vogelchr/resolver-to-sincos/resolver-to-sincos-rev-a/resolver-to-sincos.pdf

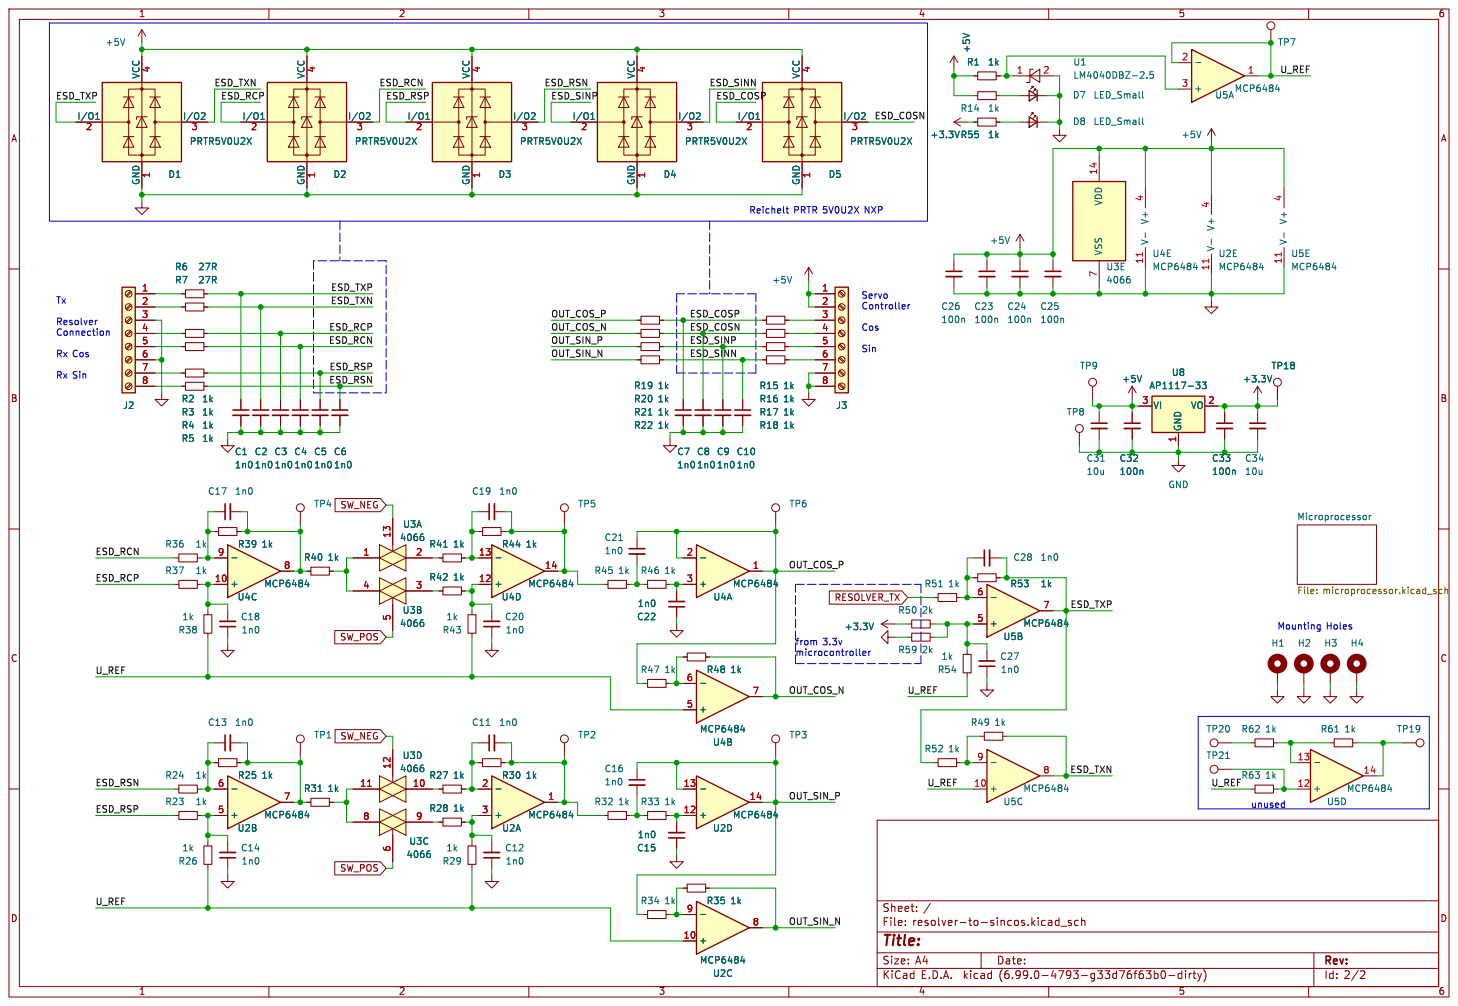
[picture p1: page 1]

from 3.3v microcontroller Servo Controller Cos Sin

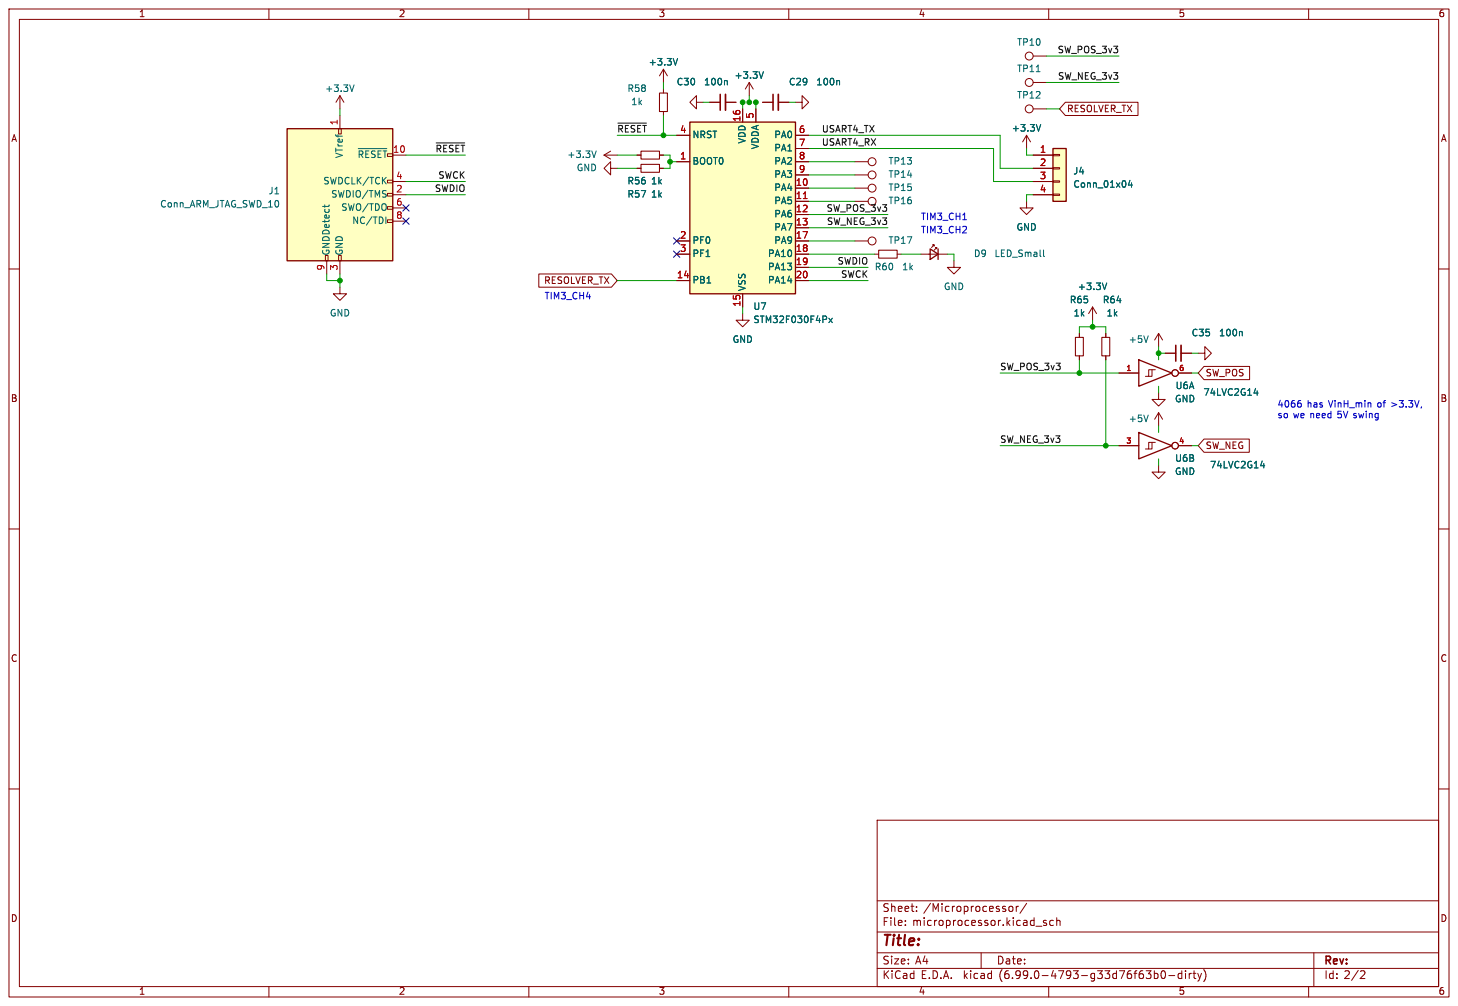
[picture p2: page 2]

3 SWDCLK/TCK 4 SWO/TDO 6 NC/TDI 8 GNDDetect 9

4066 has VinH_min of >3.3V, so we need 5V swing GND
