vogelchr/resolver-to-sincos/resolver-to-sincos.kicad_pcb

## KiCad design resolver-to-sincos.kicad_pcb (2022-12-24)

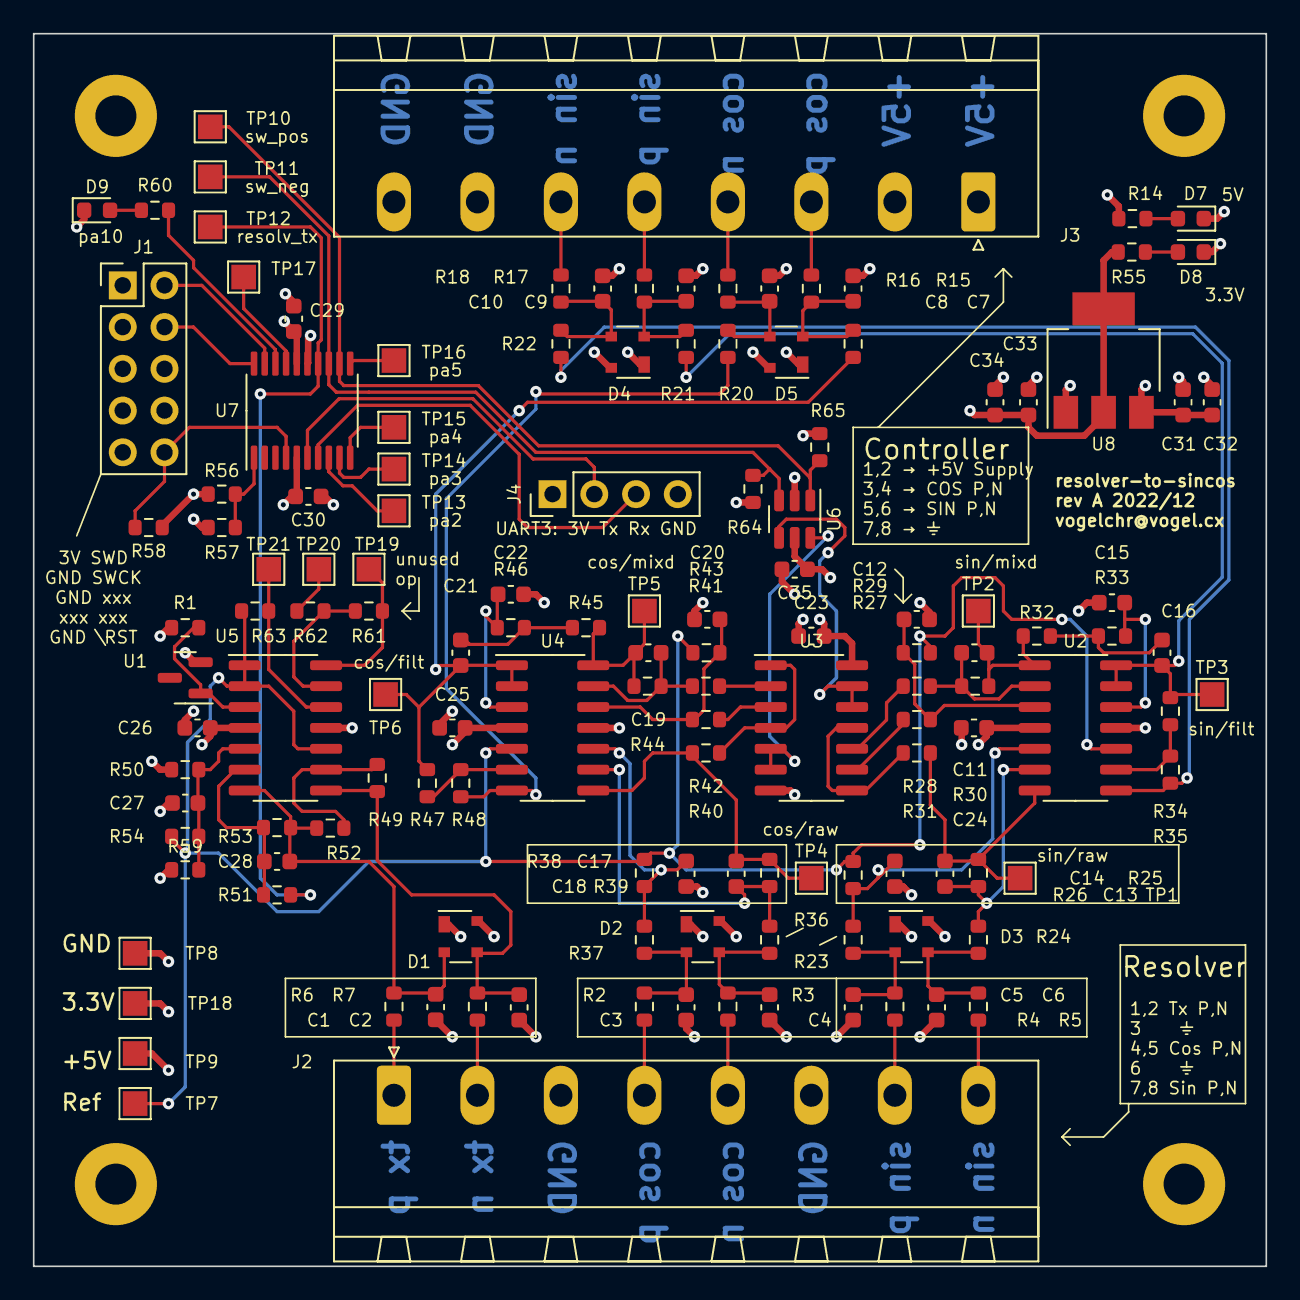
[picture p3: board resolver-to-sincos.kicad_pcb from above]

Board: 4 copper layers, 75.0 x 75.0 mm, 139 parts (0 on the bottom side), 80 nets.

Parts:
C1, C2, C3, C4, C5, C6, C7, C8, C9, C10, C11, C12, C13, C17, C19, C20: 0.1n; C_0603_1608Metric
C14, C18, C27, C28: 1n0; C_0603_1608Metric
C15, C16, C21, C22: 10n; C_0603_1608Metric
C23, C24, C25, C26, C29, C30, C32, C33, C35: 100n; C_0603_1608Metric
C31, C34: 10u; C_0603_1608Metric
D1, D2, D3, D4, D5: PRTR5V0U2X; SOT-143
D7, D8, D9: LED_Small; LED_0603_1608Metric
H1, H2, H3, H4: MountingHole_Pad; MountingHole_2.5mm_Pad
J1: Conn_ARM_JTAG_SWD_10; PinHeader_2x05_P2.54mm_Vertical
J2, J3: Screw_Terminal_01x08; PhoenixContact_MSTBA_2,5_8-G-5,08_1x08_P5.08mm_Horizontal
J4: Conn_01x04; PinHeader_1x04_P2.54mm_Vertical
R1, R14, R55, R60: 1k; R_0603_1608Metric
R2, R3, R4, R5, R23, R24, R27, R28, R31, R36, R37, R40, R41, R42, R49, R51, R52, R53, R54, R61, R62, R63: 27k; R_0603_1608Metric
R6, R7, R15, R16, R17, R18, R19, R20, R21, R22: 68R; R_0603_1608Metric
R25, R26, R29, R30, R38, R39, R43, R44, R50, R56, R57, R58, R59, R64, R65: 51k; R_0603_1608Metric
R32, R33, R34, R35, R45, R46, R47, R48: 33k; R_0603_1608Metric
TP1, TP2, TP3, TP4, TP5, TP6, TP7, TP8, TP9, TP10, TP11, TP12, TP13, TP14, TP15, TP16, TP17, TP18, TP19, TP20, TP21: TestPoint; TestPoint_Pad_1.5x1.5mm
U1: LM4040DBZ-2.5; SOT-23
U2, U4, U5: MCP6484; SOIC-14_3.9x8.7mm_P1.27mm
U3: 4066; SOIC-14_3.9x8.7mm_P1.27mm
U6: 74LVC2G14; SOT-23-6
U7: STM32F030F4Px; TSSOP-20_4.4x6.5mm_P0.65mm
U8: AP1117-33; SOT-223-3_TabPin2

Connections:
+3.3V: C29.1, C30.2, C33.1, C34.1, J1.1 (VTref), J4.1, R50.1, R55.1, R56.1, R58.1, R64.1, R65.1, TP18.1, U7.5 (VDDA), U7.16 (VDD), U8.2 (VO)
+5V: C23.1, C24.1, C25.1, C26.1, C31.1, C32.1, C35.1, D1.4 (VCC), D2.4 (VCC), D3.4 (VCC), D4.4 (VCC), D5.4 (VCC), J3.1, J3.2, R1.1, R14.1, TP9.1, U2.4 (V+), U3.14 (VDD), U4.4 (V+), U5.4 (V+), U6.5 (VCC), U8.3 (VI)
/ESD_COSN: C8.1, D5.3 (I/O2), R16.1, R20.2
/ESD_COSP: C7.1, D5.2 (I/O1), R15.1, R19.2
/ESD_RCN: C4.1, D2.3 (I/O2), R3.2, R36.1
/ESD_RCP: C3.1, D2.2 (I/O1), R2.2, R37.1
/ESD_RSN: C6.1, D3.3 (I/O2), R5.2, R24.1
/ESD_RSP: C5.1, D3.2 (I/O1), R4.2, R23.1
/ESD_SINN: C10.1, D4.3 (I/O2), R18.1, R22.2
/ESD_SINP: C9.1, D4.2 (I/O1), R17.1, R21.2
/ESD_TXN: C2.1, D1.3 (I/O2), R7.2, R49.2, U5.8
/ESD_TXP: C1.1, C28.2, D1.2 (I/O1), R6.2, R52.1, R53.2, U5.7
/Microprocessor/SWCK: J1.4 (SWDCLK/TCK), U7.20 (PA14)
/Microprocessor/SWDIO: J1.2 (SWDIO/TMS), U7.19 (PA13)
/Microprocessor/SW_NEG_3v3: R64.2, TP11.1, U6.3, U7.13 (PA7)
/Microprocessor/SW_POS_3v3: R65.2, TP10.1, U6.1, U7.12 (PA6)
/Microprocessor/USART4_RX: J4.3, U7.7 (PA1)
/Microprocessor/USART4_TX: J4.2, U7.6 (PA0)
/Microprocessor/~RESET: J1.10 (~RESET), R58.2, U7.4 (NRST)
/OUT_COS_N: R20.1, R48.2, U4.7
/OUT_COS_P: C21.1, R19.1, R47.1, TP6.1, U4.1, U4.2 (-)
/OUT_SIN_N: R22.1, R35.2, U2.8
/OUT_SIN_P: C16.1, R21.1, R34.1, TP3.1, U2.13 (-), U2.14
/U_REF: R26.1, R29.1, R38.1, R43.1, R54.1, R63.1, TP7.1, U2.10 (+), U4.5 (+), U5.1, U5.2 (-), U5.10 (+)
GND: C1.2, C2.2, C3.2, C4.2, C5.2, C6.2, C7.2, C8.2, C9.2, C10.2, C12.1, C14.1, C15.1, C18.1, C20.1, C22.1, C23.2, C24.2, C25.2, C26.2, C27.1, C29.2, C30.1, C31.2, C32.2, C33.2, C34.2, C35.2, D1.1 (GND), D2.1 (GND), D3.1 (GND), D4.1 (GND), D5.1 (GND), D7.1 (K), D8.1 (K), D9.1 (K), H1.1, H2.1, H3.1, H4.1, J1.3 (GND), J1.5 (GND), J1.9 (GNDDetect), J2.3, J2.6, J3.7, J3.8, J4.4, R57.1, R59.1, TP8.1, U1.2 (A), U2.11 (V-), U3.7 (VSS), U4.11 (V-), U5.11 (V-), U6.2 (GND), U7.15 (VSS), U8.1 (GND)
unnamed: C11.2, R30.2, R32.1, TP2.1, U2.1
unnamed: C13.2, R25.2, R31.1, TP1.1, U2.7
unnamed: C16.2, R32.2, R33.1
unnamed: C17.2, R39.2, R40.1, TP4.1, U4.8
unnamed: C19.2, R44.2, R45.1, TP5.1, U4.14
unnamed: C21.2, R45.2, R46.1
unnamed: D7.2 (A), R14.2
unnamed: D8.2 (A), R55.2
unnamed: D9.2 (A), R60.2
unnamed: J2.1, R6.1
unnamed: J2.2, R7.1
unnamed: J2.4, R2.1
unnamed: J2.5, R3.1
unnamed: J2.7, R4.1
unnamed: J2.8, R5.1
unnamed: J3.3, R15.2
unnamed: J3.4, R16.2
unnamed: J3.5, R17.2
unnamed: J3.6, R18.2
unnamed: R27.1, U3.10
unnamed: R28.1, U3.9
unnamed: R31.2, U3.8, U3.11
unnamed: R40.2, U3.1, U3.4
unnamed: R41.1, U3.2
unnamed: R42.1, U3.3
unnamed: R61.2, TP19.1, U5.14
unnamed: R62.1, TP20.1
unnamed: R1.2, U1.1 (K), U5.3 (+)
unnamed: C12.2, R28.2, R29.2, U2.3 (+)
unnamed: C11.1, R27.2, R30.1, U2.2 (-)
unnamed: C14.2, R23.2, R26.2, U2.5 (+)
unnamed: C13.1, R24.2, R25.1, U2.6 (-)
unnamed: R34.2, R35.1, U2.9 (-)
unnamed: C15.2, R33.2, U2.12 (+)
unnamed: C22.2, R46.2, U4.3 (+)
unnamed: R47.2, R48.1, U4.6 (-)
unnamed: C18.2, R37.2, R38.2, U4.10 (+)
unnamed: C17.1, R36.2, R39.1, U4.9 (-)
unnamed: C20.2, R42.2, R43.2, U4.12 (+)
unnamed: C19.1, R41.2, R44.1, U4.13 (-)
unnamed: C27.2, R50.2, R54.2, R59.2, U5.5 (+)
unnamed: C28.1, R51.2, R53.1, U5.6 (-)
unnamed: R49.1, R52.2, U5.9 (-)
unnamed: R63.2, TP21.1, U5.12 (+)
unnamed: R61.1, R62.2, U5.13 (-)
unnamed: R56.2, R57.2, U7.1 (BOOT0)
unnamed: TP13.1, U7.8 (PA2)
unnamed: TP14.1, U7.9 (PA3)
unnamed: TP15.1, U7.10 (PA4)
unnamed: TP16.1, U7.11 (PA5)
unnamed: TP17.1, U7.17 (PA9)
unnamed: R60.1, U7.18 (PA10)
RESOLVER_TX: R51.1, TP12.1, U7.14 (PB1)
SW_NEG: U3.12, U3.13, U6.4
SW_POS: U3.5, U3.6, U6.6
