vogelchr/resolver-to-sincos/(commit log)

2022-12-11 reva - draft
    [microprocessor.kicad_sch, resolver-to-sincos.kicad_pcb, resolver-to-sincos.kicad_sch]
2022-12-11 cleanup rev-a
    [microprocessor.kicad_sch, resolver-to-sincos.kicad_pcb, resolver-to-sincos.kicad_sch]
2022-12-11 gerbers, drills, schematic pdf for rev a
    [resolver-to-sincos-B_Cu.gbr, resolver-to-sincos-B_Mask.gbr, resolver-to-sincos-B_Paste.gbr, resolver-to-sincos-B_Silkscreen.gbr, resolver-to-sincos-Edge_Cuts.gbr, resolver-to-sincos-F_Cu.gbr, resolver-to-sincos-F_Mask.gbr, resolver-to-sincos-F_Paste.gbr]
2022-12-11 reva - small tweaks
    [resolver-to-sincos-B_Cu.gbr, resolver-to-sincos-B_Mask.gbr, resolver-to-sincos-B_Paste.gbr, resolver-to-sincos-B_Silkscreen.gbr, resolver-to-sincos-Edge_Cuts.gbr, resolver-to-sincos-F_Cu.gbr, resolver-to-sincos-F_Mask.gbr, resolver-to-sincos-F_Paste.gbr]
2022-12-24 Notes during bringup of rev. a.
    [microprocessor.kicad_sch, resolver-to-sincos.kicad_pcb, resolver-to-sincos.kicad_sch]
2022-12-24 Start working on firmware for stm32f0
